z4yx/SMTPnP/hardware/BOM.xlsx

Sheet: ControlBoard
Designator | Comment | Footprint | Value | Quantity
J1 | MINI-USB | Mini USB female |  | 1
D3 | Power | LED-0805 |  | 1
D7 | STATE | LED-0805 |  | 1
U1 | STM32F103RCT6 | LQFP64_N |  | 1
R10 | Res Semi | R-1608[0603] | 2.2K | 1
R11, R12 | Res Semi | R-1608[0603] | 360 | 2
R19 | Res Semi | R-1608[0603] | 200K | 1
R2, R3 | Res Semi | R-1608[0603] | 22 | 2
R21 | Res Semi | R-1608[0603] | 40.2K | 1
R22 | Res Semi | R-1608[0603] | 210K | 1
R4, R5 | Res Semi | R-1608[0603] | 1K | 2
R8, R15, R16, R17, R18, R20 | Res Semi | R-1608[0603] | 100K | 6
R9 | Res Semi | R-1608[0603] | 1.5K | 1
D2, D5 | 1N5822 | DO-214AC |  | 2
C15, C16, C17 | Cap Pol3 | C-2012[0805] | 10u | 3
C20 | Cap Pol3 | C1206 | 22uF | 1
C21 | Cap Pol3 | C1206 | 10u | 1
Q1 | 8550 | SOT23B |  | 1
L1 | Inductor | L0603 | 10uH | 1
L2 | Inductor | GDRH104R | 15uH | 1
F1 |  | 2012[0805] | 500mA | 1
Y1 | 8M | Crystal_C |  | 1
C1, C2, C3, C4, C6, C10, C11, C12, C13, C14 | Cap Semi | C-1608[0603] | 0.1u | 10
C18 | Cap Semi | C-1608[0603] | 100nF | 1
C19 | Cap Semi | C-1608[0603] | 150pF | 1
C5 | Cap Semi | C-1608[0603] | 1u | 1
U2 | REG1117-3.3 | SOT223-3D |  | 1
RP1, RP2 |  | R0603x4 | 10K | 2
U3 | MP1584 | MP1584 |  | 1

Sheet: OneMotor
Designator | Comment | Footprint | Value | Quantity
R1, R2 | Res Semi | R-6332[2512] | 0.22 | 2
R3, R4 | Res Semi | R-1608[0603] | 51K | 2
R5, R6 | Res Semi | R-1608[0603] | 5.1K | 2
C7 | 50V | RB.1/.25 | 10uF | 1
C1, C2, C3, C6 | Cap Semi | C-1608[0603] | 0.1u | 4
C4 | Cap Semi | C-1608[0603] | 100p | 1
C5 | Cap Semi | C-1608[0603] | 200p | 1
U1 | LV8731 | LV8731_V3 |  | 1

Sheet: DriverBoard
Designator | Comment | Footprint | Value | Quantity
R1, R2, R3, R4 | Res Semi | R-1608[0603] | 47K | 4
D1, D2 | 1N5819 | DO-214AC |  | 2
Q1, Q2 | PSMN7R0-30YL | SOT669 |  | 2
J1 | 5.5mm DC socket | DC_POWER |  | 1
