z4yx/SMTPnP/hardware/DriverBoard.pdf

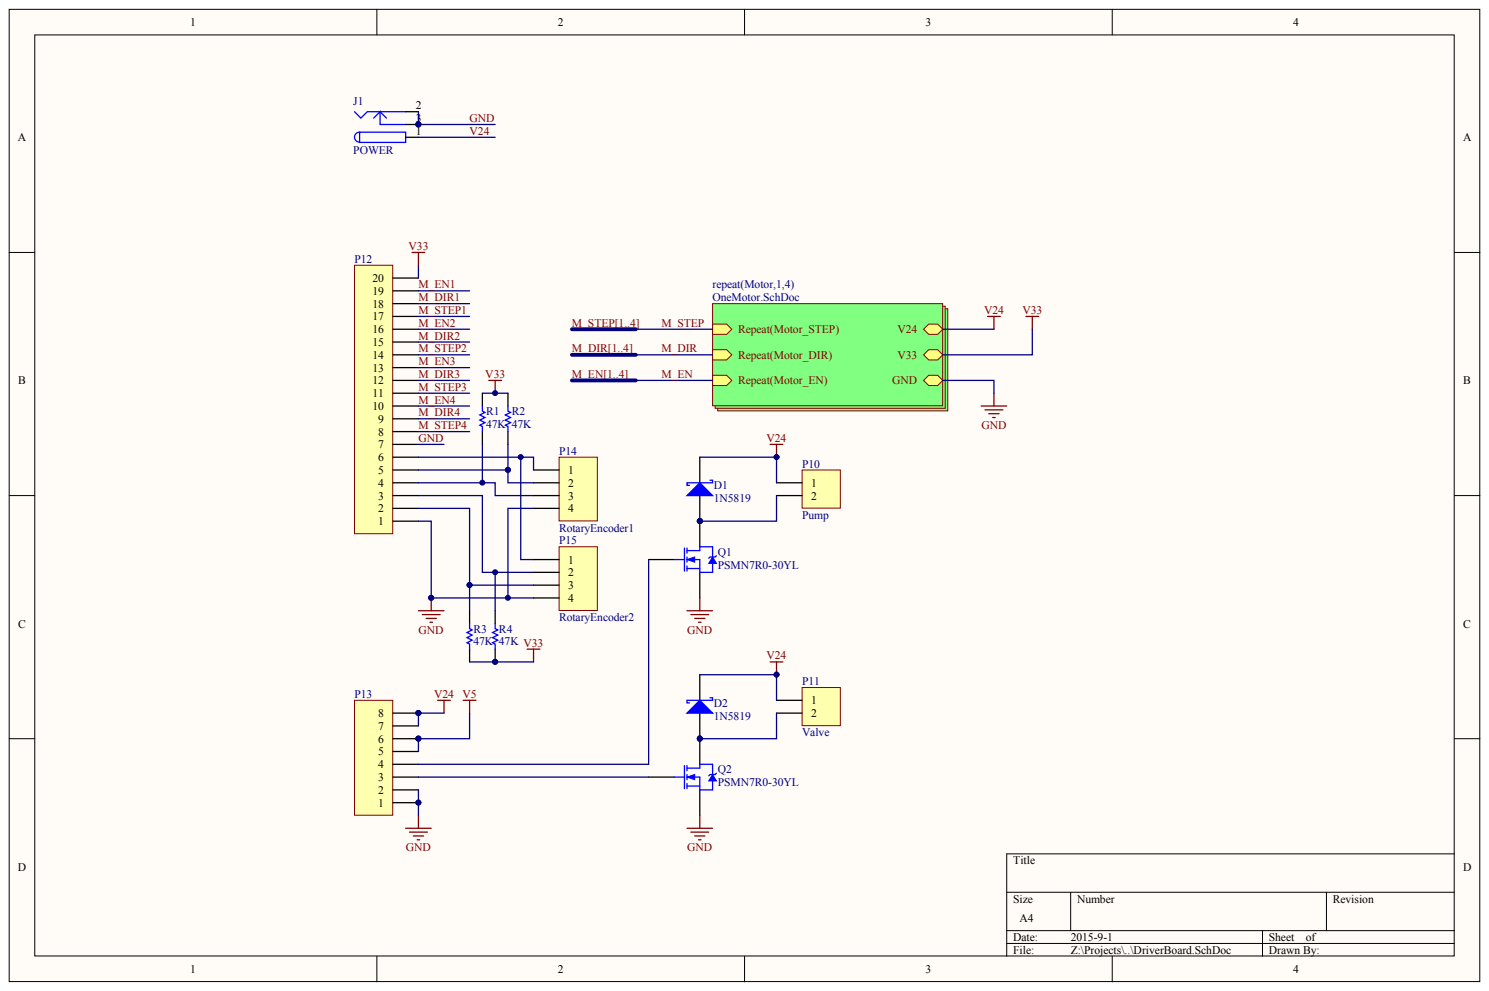
[picture p3: page 1]

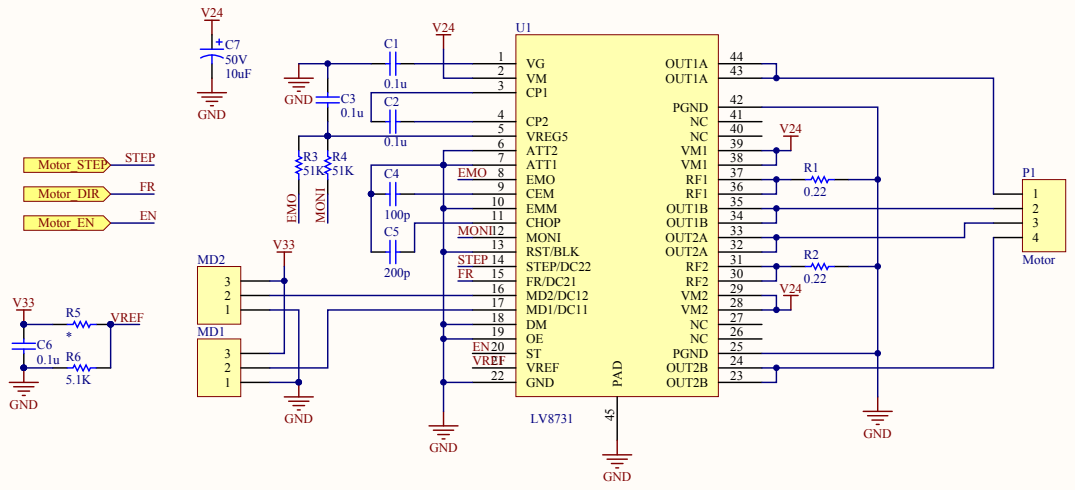
[picture p4: page 2]

EMO | 8 9

EMM 10
CHOP 11
MONI | | MONI 12 RST/BLK 13

MD1/DC11 17
DM 18

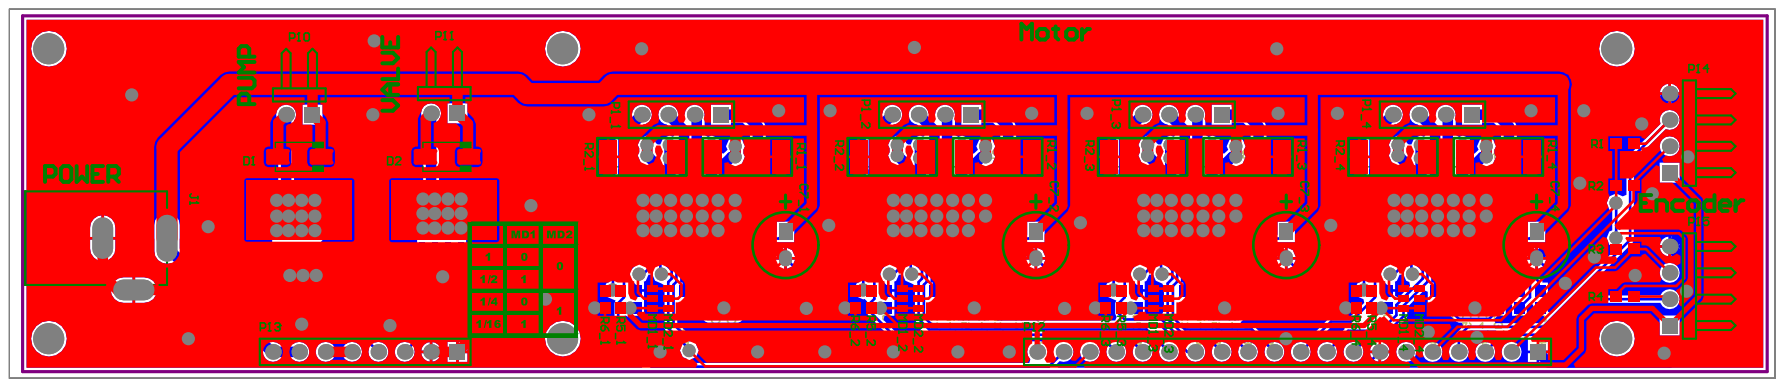
[picture p5: page 3]
