z4yx/SMTPnP/(list of files, drawings)

Other design files:
hardware/ControlBoard.PrjPCB
hardware/ControlBoard.SchDoc
hardware/DriverBoard.PcbDoc
hardware/DriverBoard.PrjPCB
hardware/DriverBoard.SchDoc
hardware/OneMotor.SchDoc
hardware/PcbLib1.PcbLib
hardware/Schlib1.SchLib
