z4yx/SMTPnP/Host/debug_dialog.py

#!/usr/bin/env python
# encoding: utf-8

import wx
from wx import xrc
import comm
import util
import re
import conf

class DebugDialog(wx.Dialog):

    def __init__(self):
        wx.Dialog.__init__(self, None, -1, 'Debug Utility')

        self.res = xrc.XmlResource('debug_dialog.xrc')
        self.panel = self.res.LoadPanel(self, 'panel')
        self.panel.Fit()
        self.Fit()

        self.createText()
        self.createBtns()
        self.createSliders()

        util.CreateCloseShortcut(self)
        self.Bind(comm.EVT_RECV, self.onRecv)
        self.Bind(wx.EVT_SHOW, self.onShow)

    def createSliders(self):
        self.slider_x = xrc.XRCCTRL(self.panel, "SliderX")
        self.slider_y = xrc.XRCCTRL(self.panel, "SliderY")
        self.Bind(wx.EVT_SCROLL_THUMBRELEASE,
                  self.onSliderChangeX, self.slider_x)
        self.Bind(wx.EVT_SCROLL_THUMBRELEASE,
                  self.onSliderChangeY, self.slider_y)

    def createText(self):
        self.text_xy = xrc.XRCCTRL(self.panel, "TextXY")
        self.text_z = xrc.XRCCTRL(self.panel, "TextZ")
        self.text_rot = xrc.XRCCTRL(self.panel, "TextR")
        self.Bind(wx.EVT_TEXT_ENTER,self.onCoordTextEnter, self.text_xy)

    def createBtns(self):
        self.Btns = {
            xrc.XRCID("YPlus"): (self.onRMoveClick, "Y", 500),
            xrc.XRCID("YMinus"): (self.onRMoveClick, "Y", -500),
            xrc.XRCID("XPlus"): (self.onRMoveClick, "X", 500),
            xrc.XRCID("XMinus"): (self.onRMoveClick, "X", -500),
            xrc.XRCID("ZPlus"): (self.onZAbsMoveClick, "Z", 100),
            xrc.XRCID("ZMinus"): (self.onZAbsMoveClick, "Z", -100),
            xrc.XRCID("Rotate"): (self.onRotateClick, "A"),
            xrc.XRCID("SetCur"): (self.onCoordSetClick, "cur"),
            xrc.XRCID("SetZero"): (self.onCoordSetClick, "zero"),
            xrc.XRCID("HomeXY"): (self.onHomeXYClick, ),
            xrc.XRCID("HomeZ"): (self.onHomeZClick, ),
        }
        for (btn_id, param) in self.Btns.items():
            self.Bind(wx.EVT_BUTTON, param[0], id=btn_id)

    def getCurCoord(self):
        match = re.search('X=([-\d]+),Y=([-\d]+)', self.text_xy.GetValue())
        if match:
            c = match.groups()
            if len(c) == 2:
                return c
        return None

    def onShow(self, evt):
        comm.SendGetCoordinateCommand()

    def onRecv(self, evt):
        if evt.info == "DONE":
            print "operation '%s' done!" % evt.content
        elif evt.info == "COORD":
            coord = evt.content.split()
            self.text_xy.SetValue("({},{})".format(coord[0], coord[1]))
            self.text_z.SetValue("({})".format(coord[2]))

    def onCoordTextEnter(self, evt):
        c = self.getCurCoord()
        if not c:
            return
        x,y = c
        print "onSliderChange {} {}".format(x, y)
        comm.SendAbsoluteXYMove(int(x), int(y))

    def onSliderChangeX(self, evt):
        c = self.getCurCoord()
        if not c:
            return
        x = self.slider_x.GetValue()
        x = int(x / float(self.slider_x.GetMax()) * conf.MACH_MAX_X)
        y = c[1]
        print "onSliderChange {} {}".format(x, y)
        comm.SendAbsoluteXYMove(int(x), int(y))

    def onSliderChangeY(self, evt):
        c = self.getCurCoord()
        if not c:
            return
        x = c[0]
        y = self.slider_y.GetValue()
        y = int(y / float(self.slider_y.GetMax()) * conf.MACH_MAX_Y)
        print "onSliderChange {} {}".format(x, y)
        comm.SendAbsoluteXYMove(int(x), int(y))

    def onHomeXYClick(self, evt):
        comm.SendHomeXY()

    def onHomeZClick(self, evt):
        comm.SendHomeZ()

    def onCoordSetClick(self, event):
        _id = event.GetId()
        _param = self.Btns[_id]
        if _param[1] == "cur":
            c = self.getCurCoord()
            if c:
                comm.SendSetCoordinateCommand(c[0], c[1])
        elif _param[1] == "zero":
            comm.SendSetCoordinateCommand(0, 0)

    def onRotateClick(self, event):
        try:
            s = self.text_rot.GetValue()
            deg = int(s)
            comm.SendDebugCommand("A", deg)
        except Exception, e:
            raise e

    def onRMoveClick(self, event):
        _id = event.GetId()
        _param = self.Btns[_id]
        comm.SendDebugCommand(_param[1], _param[2])

    def onZAbsMoveClick(self, event):
        _id = event.GetId()
        _param = self.Btns[_id]
        match = re.search('Z=([-\d]+)', self.text_z.GetValue())
        curZ = 0
        if match:
            c = match.groups()
            if len(c):
                curZ = int(c[0])
        comm.SendDebugCommand(_param[1], _param[2]+curZ)

if __name__ == '__main__':
    app = wx.PySimpleApp()
    app.MainLoop()
    dialog = DebugDialog()
    comm.Init(win=dialog)
    dialog.ShowModal()
    # comm.SetCallbackWindow(None)
    comm.Close()
    dialog.Destroy()
