z4yx/SMTPnP/Project/src/usb/src/usbcommon.c

#include "usb_lib.h"
#include "usb_prop.h"
#include "usb_desc.h"
#include "usb_pwr.h"
#include "usbcommon.h"
#include "common.h"

ErrorStatus HSEStartUpStatus;
USART_InitTypeDef USART_InitStructure;
EXTI_InitTypeDef EXTI_InitStructure;

/*******************************************************************************
* Function Name  : Set_System
* Description    : Configures Main system clocks & power
* Input          : None.
* Return         : None.
*******************************************************************************/
static void Set_System(void)
{
#if !defined(STM32L1XX_MD) && !defined(STM32L1XX_HD) && !defined(STM32L1XX_MD_PLUS)
  GPIO_InitTypeDef GPIO_InitStructure;
#endif /* STM32L1XX_MD && STM32L1XX_XD */  

#if defined(USB_USE_EXTERNAL_PULLUP)
  GPIO_InitTypeDef  GPIO_InitStructure;
#endif /* USB_USE_EXTERNAL_PULLUP */ 
  
  /*!< At this stage the microcontroller clock setting is already configured, 
       this is done through SystemInit() function which is called from startup
       file (startup_stm32f10x_xx.s) before to branch to application main.
       To reconfigure the default setting of SystemInit() function, refer to
       system_stm32f10x.c file
     */   
#if defined(STM32L1XX_MD) || defined(STM32L1XX_HD)|| defined(STM32L1XX_MD_PLUS) || defined(STM32F37X) || defined(STM32F30X)
  /* Enable the SYSCFG module clock */
  RCC_APB2PeriphClockCmd(RCC_APB2Periph_SYSCFG, ENABLE);
#endif /* STM32L1XX_XD */ 
   
#if !defined(STM32L1XX_MD) && !defined(STM32L1XX_HD) && !defined(STM32L1XX_MD_PLUS) && !defined(STM32F37X) && !defined(STM32F30X)
  /* Enable USB_DISCONNECT GPIO clock */
  RCC_GPIOClockCmd(USB_DISCONNECT, ENABLE);

  /* Configure USB pull-up pin */
  GPIO_InitStructure.GPIO_Pin = USB_DISCONNECT_PIN;
  GPIO_InitStructure.GPIO_Speed = GPIO_Speed_50MHz;
  GPIO_InitStructure.GPIO_Mode = GPIO_Mode_Out_OD;
  GPIO_Init(USB_DISCONNECT, &GPIO_InitStructure);
#endif /* STM32L1XX_MD && STM32L1XX_XD */
   
#if defined(USB_USE_EXTERNAL_PULLUP)
  /* Enable the USB disconnect GPIO clock */
  RCC_AHBPeriphClockCmd(RCC_AHBPeriph_GPIO_DISCONNECT, ENABLE);

  /* USB_DISCONNECT used as USB pull-up */
  GPIO_InitStructure.GPIO_Pin = USB_DISCONNECT_PIN;
  GPIO_InitStructure.GPIO_Mode = GPIO_Mode_OUT;
  GPIO_InitStructure.GPIO_Speed = GPIO_Speed_2MHz;
  GPIO_InitStructure.GPIO_OType = GPIO_OType_PP;
  GPIO_InitStructure.GPIO_PuPd = GPIO_PuPd_NOPULL;
  GPIO_Init(USB_DISCONNECT, &GPIO_InitStructure);  
#endif /* USB_USE_EXTERNAL_PULLUP */ 
  
#if defined(STM32F37X) || defined(STM32F30X)
  
  /* Enable the USB disconnect GPIO clock */
  RCC_AHBPeriphClockCmd(RCC_AHBPeriph_GPIO_DISCONNECT, ENABLE);
  
  /*Set PA11,12 as IN - USB_DM,DP*/
  RCC_AHBPeriphClockCmd(RCC_AHBPeriph_GPIOA, ENABLE);
  GPIO_InitStructure.GPIO_Pin = GPIO_Pin_11 | GPIO_Pin_12;
  GPIO_InitStructure.GPIO_Speed = GPIO_Speed_50MHz;
  GPIO_InitStructure.GPIO_Mode = GPIO_Mode_AF;
  GPIO_InitStructure.GPIO_OType = GPIO_OType_PP;
  GPIO_InitStructure.GPIO_PuPd = GPIO_PuPd_NOPULL;
  GPIO_Init(GPIOA, &GPIO_InitStructure);
  
  /*SET PA11,12 for USB: USB_DM,DP*/
  GPIO_PinAFConfig(GPIOA, GPIO_PinSource11, GPIO_AF_14);
  GPIO_PinAFConfig(GPIOA, GPIO_PinSource12, GPIO_AF_14);
  
  /* USB_DISCONNECT used as USB pull-up */
  GPIO_InitStructure.GPIO_Pin = USB_DISCONNECT_PIN;
  GPIO_InitStructure.GPIO_Speed = GPIO_Speed_2MHz;
  GPIO_InitStructure.GPIO_Mode = GPIO_Mode_OUT;
  GPIO_InitStructure.GPIO_OType = GPIO_OType_OD;
  GPIO_InitStructure.GPIO_PuPd = GPIO_PuPd_NOPULL;
  GPIO_Init(USB_DISCONNECT, &GPIO_InitStructure);
#endif /* STM32F37X && STM32F30X */ 
  
  /* Configure the EXTI line 18 connected internally to the USB IP */
  EXTI_ClearITPendingBit(EXTI_Line18);
  EXTI_InitStructure.EXTI_Line = EXTI_Line18; 
  EXTI_InitStructure.EXTI_Trigger = EXTI_Trigger_Rising;
  EXTI_InitStructure.EXTI_LineCmd = ENABLE;
  EXTI_Init(&EXTI_InitStructure);
}

/*******************************************************************************
* Function Name  : Set_USBClock
* Description    : Configures USB Clock input (48MHz)
* Input          : None.
* Return         : None.
*******************************************************************************/
void Set_USBClock(void)
{
#if defined(STM32L1XX_MD) || defined(STM32L1XX_HD) || defined(STM32L1XX_MD_PLUS) 
  /* Enable USB clock */
  RCC_APB1PeriphClockCmd(RCC_APB1Periph_USB, ENABLE);
  
#else 
  /* Select USBCLK source */
  RCC_USBCLKConfig(RCC_USBCLKSource_PLLCLK_1Div5);
  
  /* Enable the USB clock */
  RCC_APB1PeriphClockCmd(RCC_APB1Periph_USB, ENABLE);
#endif /* STM32L1XX_MD */
}

void USBCommon_Init(void)
{
  Set_System();
  Set_USBClock();
  USB_Interrupts_Config();
}


/*******************************************************************************
* Function Name  : Enter_LowPowerMode
* Description    : Power-off system clocks and power while entering suspend mode
* Input          : None.
* Return         : None.
*******************************************************************************/
void Enter_LowPowerMode(void)
{
  /* Set the device state to suspend */
  bDeviceState = SUSPENDED;
}

/*******************************************************************************
* Function Name  : Leave_LowPowerMode
* Description    : Restores system clocks and power while exiting suspend mode
* Input          : None.
* Return         : None.
*******************************************************************************/
void Leave_LowPowerMode(void)
{
  DEVICE_INFO *pInfo = &Device_Info;

  /* Set the device state to the correct state */
  if (pInfo->Current_Configuration != 0)
  {
    /* Device configured */
    bDeviceState = CONFIGURED;
  }
  else
  {
    bDeviceState = ATTACHED;
  }
  /*Enable SystemCoreClock*/
  SystemInit();
}

/*******************************************************************************
* Function Name  : USB_Interrupts_Config
* Description    : Configures the USB interrupts
* Input          : None.
* Return         : None.
*******************************************************************************/
void USB_Interrupts_Config(void)
{
  NVIC_InitTypeDef NVIC_InitStructure; 
  
  /* 2 bit for pre-emption priority, 2 bits for subpriority */
  NVIC_PriorityGroupConfig(NVIC_PriorityGroup_2);  
  
#if defined(STM32L1XX_MD) || defined(STM32L1XX_HD)|| defined(STM32L1XX_MD_PLUS)
  NVIC_InitStructure.NVIC_IRQChannel = USB_LP_IRQn;
  NVIC_InitStructure.NVIC_IRQChannelPreemptionPriority = 2;
  NVIC_InitStructure.NVIC_IRQChannelSubPriority = 0;
  NVIC_InitStructure.NVIC_IRQChannelCmd = ENABLE;
  NVIC_Init(&NVIC_InitStructure);
  
    /* Enable the USB Wake-up interrupt */
  NVIC_InitStructure.NVIC_IRQChannel = USB_FS_WKUP_IRQn;
  NVIC_InitStructure.NVIC_IRQChannelPreemptionPriority = 0;
  NVIC_InitStructure.NVIC_IRQChannelCmd = ENABLE;
  NVIC_Init(&NVIC_InitStructure);
  
#elif defined(STM32F37X)
  /* Enable the USB interrupt */
  NVIC_InitStructure.NVIC_IRQChannel = USB_LP_IRQn;
  NVIC_InitStructure.NVIC_IRQChannelPreemptionPriority = 2;
  NVIC_InitStructure.NVIC_IRQChannelSubPriority = 0;
  NVIC_InitStructure.NVIC_IRQChannelCmd = ENABLE;
  NVIC_Init(&NVIC_InitStructure);
  
  /* Enable the USB Wake-up interrupt */
  NVIC_InitStructure.NVIC_IRQChannel = USBWakeUp_IRQn;
  NVIC_InitStructure.NVIC_IRQChannelPreemptionPriority = 0;
  NVIC_InitStructure.NVIC_IRQChannelCmd = ENABLE;
  NVIC_Init(&NVIC_InitStructure);
  
#else
  NVIC_InitStructure.NVIC_IRQChannel = USB_LP_CAN1_RX0_IRQn;
  NVIC_InitStructure.NVIC_IRQChannelPreemptionPriority = 2;
  NVIC_InitStructure.NVIC_IRQChannelSubPriority = 0;
  NVIC_InitStructure.NVIC_IRQChannelCmd = ENABLE;
  NVIC_Init(&NVIC_InitStructure);
  
    /* Enable the USB Wake-up interrupt */
  NVIC_InitStructure.NVIC_IRQChannel = USBWakeUp_IRQn;
  NVIC_InitStructure.NVIC_IRQChannelPreemptionPriority = 0;
  NVIC_Init(&NVIC_InitStructure);
#endif /* STM32L1XX_XD */

}

/*******************************************************************************
* Function Name  : USB_Cable_Config
* Description    : Software Connection/Disconnection of USB Cable
* Input          : None.
* Return         : Status
*******************************************************************************/
void USB_Cable_Config (FunctionalState NewState)
{
  if (NewState != DISABLE)
  {
    GPIO_ResetBits(USB_DISCONNECT, USB_DISCONNECT_PIN);
  }
  else
  {
    GPIO_SetBits(USB_DISCONNECT, USB_DISCONNECT_PIN);
  }
}

/*******************************************************************************
* Function Name  : Get_SerialNum.
* Description    : Create the serial number string descriptor.
* Input          : None.
* Output         : None.
* Return         : None.
*******************************************************************************/
void Get_SerialNum(void)
{
  uint32_t Device_Serial0, Device_Serial1, Device_Serial2;

  Device_Serial0 = 0xdeadbeef;
  Device_Serial1 = 0xaa55aa55;
  Device_Serial2 = 0;  

  Device_Serial0 += Device_Serial2;

  if (Device_Serial0 != 0)
  {
    IntToUnicode (Device_Serial0, &Virtual_Com_Port_StringSerial[2] , 8);
    IntToUnicode (Device_Serial1, &Virtual_Com_Port_StringSerial[18], 4);
  }
}

/*******************************************************************************
* Function Name  : HexToChar.
* Description    : Convert Hex 32Bits value into char.
* Input          : None.
* Output         : None.
* Return         : None.
*******************************************************************************/
void IntToUnicode (uint32_t value , uint8_t *pbuf , uint8_t len)
{
  uint8_t idx = 0;
  
  for( idx = 0 ; idx < len ; idx ++)
  {
    if( ((value >> 28)) < 0xA )
    {
      pbuf[ 2* idx] = (value >> 28) + '0';
    }
    else
    {
      pbuf[2* idx] = (value >> 28) + 'A' - 10; 
    }
    
    value = value << 4;
    
    pbuf[ 2* idx + 1] = 0;
  }
}
