z4yx/SMTPnP/Project/src/lowlevel/usart.c

/*
 * =====================================================================================
 *
 *       Filename:  usart.c
 *
 *    Description:  USART收发与调试输出
 *
 *        Version:  
 *        Created:  
 *       Revision:  
 *       Compiler:  
 *
 *         Author:  zhangyuxiang
 *   Organization:  
 *
 * =====================================================================================
 */

#include "common.h"
#include "usart.h"
#include <stdarg.h>

/*
 * 初始化串口配置
 */
void USART_Config(USART_TypeDef* USARTx, u32 USART_BaudRate)
{
    GPIO_InitTypeDef GPIO_InitStructure;
    USART_InitTypeDef USART_InitStructure;
    GPIO_TypeDef *USART_GPIO;
    u16 USART_Rx, USART_Tx;
    uint16_t PinSource_Rx, PinSource_Tx;
    uint8_t  GPIO_AF;

    switch((u32)USARTx) {
        case (u32)USART1:
            USART_GPIO = GPIOA;
            USART_Tx = GPIO_Pin_9;
            USART_Rx = GPIO_Pin_10;
            PinSource_Tx = GPIO_PinSource9;
            PinSource_Rx = GPIO_PinSource10;
#ifdef IS_GPIO_OTYPE //New GPIO peripheral
            GPIO_AF  = GPIO_AF_USART1;
#endif
            break;
        case (u32)USART2:
            USART_GPIO = GPIOA;
            USART_Tx = GPIO_Pin_2;
            USART_Rx = GPIO_Pin_3;
            PinSource_Tx = GPIO_PinSource2;
            PinSource_Rx = GPIO_PinSource3;
#ifdef IS_GPIO_OTYPE //New GPIO peripheral
            GPIO_AF  = GPIO_AF_USART2;
#endif
            break;
        case (u32)USART3:
            USART_GPIO = GPIOB;
            USART_Tx = GPIO_Pin_10;
            USART_Rx = GPIO_Pin_11;
            PinSource_Tx = GPIO_PinSource10;
            PinSource_Rx = GPIO_PinSource11;
#ifdef IS_GPIO_OTYPE //New GPIO peripheral
            GPIO_AF  = GPIO_AF_USART3;
#endif
            break;

        default:
            return;
    }

    /* config USART clock */
    RCC_USARTClockCmd(USARTx, ENABLE);

    /* USART GPIO config */
    RCC_GPIOClockCmd(USART_GPIO, ENABLE);
#ifdef IS_GPIO_OTYPE //New GPIO peripheral
    GPIO_PinAFConfig(USART_GPIO, PinSource_Rx, GPIO_AF);
    GPIO_PinAFConfig(USART_GPIO, PinSource_Tx, GPIO_AF);
#endif
    /* Configure USART Tx as alternate function push-pull */
    GPIO_InitStructure.GPIO_Pin = USART_Tx;
#ifdef IS_GPIO_OTYPE //New GPIO peripheral
    GPIO_InitStructure.GPIO_OType = GPIO_OType_PP;
    GPIO_InitStructure.GPIO_PuPd = GPIO_PuPd_NOPULL;
    GPIO_InitStructure.GPIO_Mode = GPIO_Mode_AF;
#else
    GPIO_InitStructure.GPIO_Mode = GPIO_Mode_AF_PP;
#endif
    GPIO_InitStructure.GPIO_Speed = GPIO_Speed_50MHz;
    GPIO_Init(USART_GPIO, &GPIO_InitStructure);
    /* Configure USART Rx as input*/
    GPIO_InitStructure.GPIO_Pin = USART_Rx;
#ifdef IS_GPIO_OTYPE //New GPIO peripheral
    GPIO_InitStructure.GPIO_OType = GPIO_OType_PP;
    GPIO_InitStructure.GPIO_PuPd = GPIO_PuPd_UP;
    GPIO_InitStructure.GPIO_Mode = GPIO_Mode_AF;
#else
    GPIO_InitStructure.GPIO_Mode = GPIO_Mode_IPU;
#endif
    GPIO_Init(USART_GPIO, &GPIO_InitStructure);

    /* USART mode config */
    USART_InitStructure.USART_BaudRate = USART_BaudRate;
    USART_InitStructure.USART_WordLength = USART_WordLength_8b;
    USART_InitStructure.USART_StopBits = USART_StopBits_1;
    USART_InitStructure.USART_Parity = USART_Parity_No ;
    USART_InitStructure.USART_HardwareFlowControl = USART_HardwareFlowControl_None;
    USART_InitStructure.USART_Mode = USART_Mode_Rx | USART_Mode_Tx;
    USART_Init(USARTx, &USART_InitStructure);
    USART_Cmd(USARTx, ENABLE);
}

/*
 * 串口接收中断配置
 */
void USART_RxInt_Config(bool bEnabled)
{
    NVIC_InitTypeDef NVIC_InitStructure;
    NVIC_InitStructure.NVIC_IRQChannel = USART1_IRQn; //指定中断源
    NVIC_InitStructure.NVIC_IRQChannelPreemptionPriority = 0;
    NVIC_InitStructure.NVIC_IRQChannelSubPriority = 0;   // 指定响应优先级别
    NVIC_InitStructure.NVIC_IRQChannelCmd = (bEnabled ? ENABLE : DISABLE);
    NVIC_Init(&NVIC_InitStructure);

    USART_ITConfig(USART1, USART_IT_RXNE, (bEnabled ? ENABLE : DISABLE));
}

/*
 * 通过串口发送一个字节
 */
int USART_putchar(USART_TypeDef* USARTx, int ch)
{

    USART_SendData(USARTx, (unsigned char) ch);
    while (!(USARTx->SR & USART_FLAG_TXE));

    return (ch);
}

/*
 * 通过串口接收一个字节
 */
int USART_getchar(USART_TypeDef* USARTx)
{
    uint8_t ch;
    while (SET != USART_GetFlagStatus(USARTx, USART_FLAG_RXNE));
    ch = USART_ReceiveData(USARTx);
    USART_ClearFlag(USARTx, USART_FLAG_RXNE);
    return (ch);
}

/*
 * 读入一个整数值
 */
int USART_ReadInt(USART_TypeDef* USARTx)
{
    uint8_t neg = 0;
    int c = USART_getchar(USARTx), ret = 0;
    while(c<'0'||c>'9'){
        if(c=='-')
            neg = 1;
        c = USART_getchar(USARTx);
    }
    while(c>='0'&&c<='9'){
        ret = ret*10+(c-'0');
        c = USART_getchar(USARTx);
    }
    return neg ? -ret : ret;
}

/*
 * 数值转字符串函数
 */
static char *itoa(int value, char *string, int radix)
{
    int     i, d;
    int     flag = 0;
    char    *ptr = string;

    /* This implementation only works for decimal numbers. */
    if (radix != 10)
    {
        *ptr = 0;
        return string;
    }

    if (!value)
    {
        *ptr++ = 0x30;
        *ptr = 0;
        return string;
    }

    /* if this is a negative value insert the minus sign. */
    if (value < 0)
    {
        *ptr++ = '-';

        /* Make the value positive. */
        value *= -1;
    }

    for (i = 1000000000; i > 0; i /= 10)
    {
        d = value / i;

        if (d || flag)
        {
            *ptr++ = (char)(d + 0x30);
            value -= (d * i);
            flag = 1;
        }
    }

    /* Null terminate the string. */
    *ptr = 0;

    return string;

} /* NCL_Itoa */

/*
 * 通过串口发送格式化字符串
 */
void USART_printf(USART_TypeDef* USARTx, char *Data, ...)
{
    const char *s;
    int d;
    char buf[16];

    va_list ap;
    va_start(ap, Data);

    while ( *Data != 0)
    {
        if ( *Data == '\\' )
        {
            switch ( *++Data )
            {
            case 'r':
                USART_SendData(USARTx, 0x0d);
                Data ++;
                break;

            case 'n':
                USART_SendData(USARTx, 0x0a);
                Data ++;
                break;

            default:
                Data ++;
                break;
            }
        }
        else if ( *Data == '%')
        {
            switch ( *++Data )
            {
            case 's':
                s = va_arg(ap, const char *);
                for ( ; *s; s++)
                {
                    USART_SendData(USARTx, *s);
                    while ( USART_GetFlagStatus(USARTx, USART_FLAG_TC) == RESET );
                }
                Data++;
                break;

            case 'd':
                d = va_arg(ap, int);
                itoa(d, buf, 10);
                for (s = buf; *s; s++)
                {
                    USART_SendData(USARTx, *s);
                    while ( USART_GetFlagStatus(USARTx, USART_FLAG_TC) == RESET );
                }
                Data++;
                break;
            default:
                Data++;
                break;
            }
        } /* end of else if */
        else USART_SendData(USARTx, *Data++);
        while ( USART_GetFlagStatus(USARTx, USART_FLAG_TC) == RESET );
    }
}
