z4yx/SMTPnP/Project/src/usb/src/usbcdc.c

/**
  ******************************************************************************
  * @file    hw_config.c
  * @author  MCD Application Team
  * @version V4.0.0
  * @date    21-January-2013
  * @brief   Hardware Configuration & Setup
  ******************************************************************************
  * @attention
  *
  * <h2><center>&copy; COPYRIGHT 2013 STMicroelectronics</center></h2>
  *
  * Licensed under MCD-ST Liberty SW License Agreement V2, (the "License");
  * You may not use this file except in compliance with the License.
  * You may obtain a copy of the License at:
  *
  *        http://www.st.com/software_license_agreement_liberty_v2
  *
  * Unless required by applicable law or agreed to in writing, software 
  * distributed under the License is distributed on an "AS IS" BASIS, 
  * WITHOUT WARRANTIES OR CONDITIONS OF ANY KIND, either express or implied.
  * See the License for the specific language governing permissions and
  * limitations under the License.
  *
  ******************************************************************************
  */


/* Includes ------------------------------------------------------------------*/

#include "usbcdc.h"
#include "usb_lib.h"
#include "usb_prop.h"
#include "usb_desc.h"
#include "usb_pwr.h"
#include "common.h"
#include "hostctrl.h"

/* Private typedef -----------------------------------------------------------*/
/* Private define ------------------------------------------------------------*/
/* Private macro -------------------------------------------------------------*/
/* Private variables ---------------------------------------------------------*/
static ErrorStatus HSEStartUpStatus;
static USART_InitTypeDef USART_InitStructure;
static NVIC_InitTypeDef NVIC_InitStructure; 
uint8_t  USART_Rx_Buffer [USART_RX_DATA_SIZE]; 
uint32_t USART_Rx_ptr_in = 0;
uint32_t USART_Rx_ptr_out = 0;
uint32_t USART_Rx_length  = 0;

uint8_t  USB_Tx_State = 0;
/* Extern variables ----------------------------------------------------------*/

extern LINE_CODING linecoding;

/* Private function prototypes -----------------------------------------------*/
/* Private functions ---------------------------------------------------------*/

/*******************************************************************************
* Function Name  :  USART_USB_Config_Default.
* Description    :  configure the EVAL_COM1 with default values.
* Input          :  None.
* Return         :  None.
*******************************************************************************/
void USART_USB_Config_Default(void)
{

}

/*******************************************************************************
* Function Name  :  USART_USB_Config.
* Description    :  Configure the EVAL_COM1 according to the line coding structure.
* Input          :  None.
* Return         :  Configuration status
                    TRUE : configuration done with success
                    FALSE : configuration aborted.
*******************************************************************************/
bool USART_USB_Config(void)
{

  return (TRUE);
}

/*******************************************************************************
* Function Name  : USB_To_USART_Send_Data.
* Description    : send the received data from USB to the UART 0.
* Input          : data_buffer: data address.
                   Nb_bytes: number of bytes to send.
* Return         : none.
*******************************************************************************/
void USB_To_USART_Send_Data(uint8_t* data_buffer, uint8_t Nb_bytes)
{
  
  uint32_t i;

  DBG_MSG("Len %d", Nb_bytes);
  for (i = 0; i < Nb_bytes; i++)
  {
    HostCtrl_Recv_Interrupt(*(data_buffer + i));
  }  
}

/*******************************************************************************
* Function Name  : Handle_USBAsynchXfer.
* Description    : send data to USB.
* Input          : None.
* Return         : none.
*******************************************************************************/
void Handle_USBAsynchXfer (void)
{
  
  uint16_t USB_Tx_ptr;
  uint16_t USB_Tx_length;
  
  if(USB_Tx_State != 1)
  {
    if (USART_Rx_ptr_out == USART_RX_DATA_SIZE)
    {
      USART_Rx_ptr_out = 0;
    }
    
    if(USART_Rx_ptr_out == USART_Rx_ptr_in) 
    {
      USB_Tx_State = 0; 
      return;
    }
    
    if(USART_Rx_ptr_out > USART_Rx_ptr_in) /* rollback */
    { 
      USART_Rx_length = USART_RX_DATA_SIZE - USART_Rx_ptr_out;
    }
    else 
    {
      USART_Rx_length = USART_Rx_ptr_in - USART_Rx_ptr_out;
    }
    
    if (USART_Rx_length > VIRTUAL_COM_PORT_DATA_SIZE)
    {
      USB_Tx_ptr = USART_Rx_ptr_out;
      USB_Tx_length = VIRTUAL_COM_PORT_DATA_SIZE;
      
      USART_Rx_ptr_out += VIRTUAL_COM_PORT_DATA_SIZE;	
      USART_Rx_length -= VIRTUAL_COM_PORT_DATA_SIZE;	
    }
    else
    {
      USB_Tx_ptr = USART_Rx_ptr_out;
      USB_Tx_length = USART_Rx_length;
      
      USART_Rx_ptr_out += USART_Rx_length;
      USART_Rx_length = 0;
    }
    USB_Tx_State = 1; 
    UserToPMABufferCopy(&USART_Rx_Buffer[USB_Tx_ptr], ENDP1_TXADDR, USB_Tx_length);
    SetEPTxCount(ENDP1, USB_Tx_length);
    SetEPTxValid(ENDP1); 
  }  
  
}
/*******************************************************************************
* Function Name  : UART_To_USB_Send_Data.
* Description    : send the received data from UART 0 to USB.
* Input          : None.
* Return         : none.
*******************************************************************************/
void USART_To_USB_Send_Data(uint8_t byte)
{
    __disable_irq();

    if (linecoding.datatype == 7)
    {
      USART_Rx_Buffer[USART_Rx_ptr_in] = byte & 0x7F;
    }
    else if (linecoding.datatype == 8)
    {
      USART_Rx_Buffer[USART_Rx_ptr_in] = byte;
    }
    
    USART_Rx_ptr_in++;
    
    /* To avoid buffer overflow */
    if(USART_Rx_ptr_in == USART_RX_DATA_SIZE)
    {
      USART_Rx_ptr_in = 0;
    }

    __enable_irq();
}


/************************ (C) COPYRIGHT STMicroelectronics *****END OF FILE****/
