z4yx/SMTPnP/Project/include/adc.h

#ifndef __ADC_H___
#define	__ADC_H___

#include "common.h"

void ADC_Config(uint8_t nChannel);
void ADC_Channel_Config(GPIO_TypeDef* GPIOx, uint16_t pin, uint8_t channel, uint8_t rank);
void ADC_Start(void);
int16_t ADC_Read_Value(void);


#endif
