z4yx/SMTPnP/Project/src/lowlevel/systick.c

/*
 * =====================================================================================
 *
 *       Filename:  systick.c
 *
 *    Description:  系统滴答定时器，产生系统标准时间，实现延时等待
 *
 *        Version:  
 *        Created:  
 *       Revision:  
 *       Compiler:  
 *
 *         Author:  zhangyuxiang
 *   Organization:  
 *
 * =====================================================================================
 */

#include "common.h"
#include "systick.h"

static volatile SysTick_t systemTickCounter = 0;
static uint32_t HCLK_Frequency;

void SysTick_Init(void)
{
	RCC_ClocksTypeDef RCC_Clocks;
	RCC_GetClocksFreq(&RCC_Clocks);
	HCLK_Frequency = RCC_Clocks.HCLK_Frequency;
	//产生1ms间隔的中断
	if (SysTick_Config(HCLK_Frequency / 1000))
	{
		/* Capture error */
		while (1);
	}

	// 关闭滴答定时器
	// SysTick->CTRL &= ~ SysTick_CTRL_ENABLE_Msk;
}

void IncSysTickCounter(void)
{
	systemTickCounter ++;
}

SysTick_t GetSystemTick(void)
{
	SysTick_t tmp;
	
	do {
		tmp = systemTickCounter;
		//防止读取变量过程中被中断更改
	}while(tmp != systemTickCounter);
	
	return tmp;
}

/*
 * 毫秒级延时，误差±1ms
 */
void Delay_ms(unsigned int ms)
{
	SysTick_t t = GetSystemTick();
	t += ms;
	while(GetSystemTick() < t){
#if defined (STM32F10X_LD) || defined (STM32F10X_LD_VL) || defined (STM32F10X_MD) || defined (STM32F10X_MD_VL) || defined (STM32F10X_HD) || defined (STM32F10X_HD_VL) || defined (STM32F10X_XL) || defined (STM32F10X_CL) 
		SCB->SCR &= (uint32_t)~((uint32_t)SCB_SCR_SLEEPONEXIT); // Reset SLEEPONEXIT
        SCB->SCR &= (uint32_t)~((uint32_t)SCB_SCR_SLEEPDEEP);   // Clear SLEEPDEEP bit
        __WFI();                                                // Request Wait For Interrupt
#endif
	}
}


/*
 * 微秒级延时
 */
void Delay_us(unsigned int us)
{
	uint32_t val, last;
	int32_t tmp = us*(HCLK_Frequency/1000000);

	last = SysTick->VAL;
	while(tmp > 0) {
		val = SysTick->VAL;
		if(val <= last)
			tmp -= last - val;
		else
			tmp -= last + SysTick->LOAD - val;
		last = val;
	}
}
