z4yx/SMTPnP/(commit log)

2014-05-21 basic implement of Pick-n-Place machine
    [LED.csv, test_3dprinter.csv]
2014-11-30 PCB v1.0
    [ControlBoard.PrjPCB, ControlBoard.SchDoc, DriverBoard.PcbDoc, DriverBoard.PrjPCB, DriverBoard.SchDoc, OneMotor.SchDoc, PcbLib1.PcbLib, Schlib1.SchLib]
2014-12-01 fix bool type definition
    [common.h, usbcommon.h]
2014-12-02 disable interrupt in critical area
2014-12-05 wildcard of serial device name
2014-12-05 reverse limit switch input
    [limitSwitch.c]
2014-12-06 add rotary encoder related code
2014-12-07 add XY homing, refactor motion state management
2015-02-17 fix interrupt flag name
2015-04-22 fix wrong function name
    [command.c]
2015-07-31 compatible with stm32f4
2015-08-03 Add USB-OTG driver for USB-CDC on stm32f4
2015-08-04 update pin definition for nucleo based controller
2015-08-15 fix ms sleep function
    [systick.c]
2015-08-15 reconfig PLL on f411 to get correct USB clock
    [main.c]
2015-08-16 fix RCC function name
    [common.c]
2015-08-16 fix square root calculation
    [common.c]
2015-08-16 add motor interrupt handle for stm32f4
2015-08-16 fix Z moving in GUI
    [debug_dialog.py]
2015-08-16 using retargeted printf to print debug message
2015-08-16 fix motor connection
2015-08-16 fix compilation on stm32F1
    [main.c]
2015-08-29 firmware: support for Z-axis reset
    [command.c, command.h, hostctrl.c, limitSwitch.c, toolhead.c, toolhead.h]
2015-08-29 update firmware and host for machinery design
    [LED.csv]
2015-09-01 update author info in schematics
    [DriverBoard.PrjPCB, DriverBoard.SchDoc, OneMotor.SchDoc]
2015-09-01 reserve TIM for rotary encoder
2015-09-02 fix pin alternate function config of rotary encoder
    [common.c, common.h, rotary_encoder.c, rotary_encoder.h]
2015-09-07 remove useless file
    [test_3dprinter.csv]
2015-09-16 add BOM
    [BOM.xlsx, ControlBoard.SchDoc]
2016-01-02 bug fix: 0 degree rotation
    [toolhead.c]
2016-01-02 do more Z-home to fix machinery error
    [main.py, move.py]
